DreamteamWRO/DreamteamWRO/IMG20260910141040.jpg

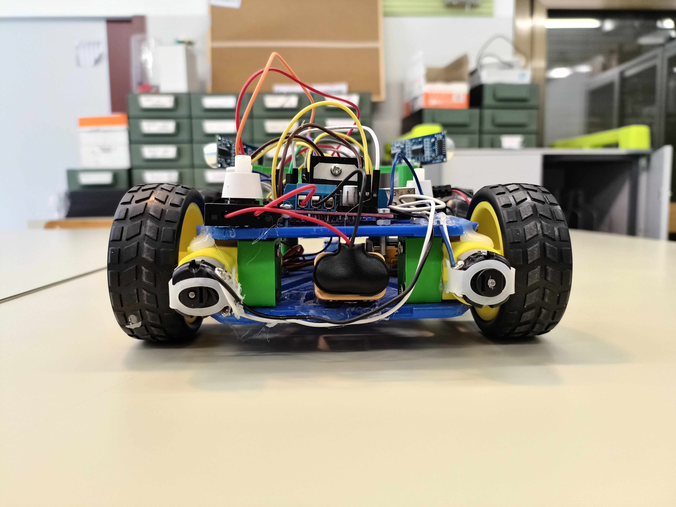
IMG20260910141040.jpg
