DreamteamWRO/DreamteamWRO/IMG20260910141033.jpg

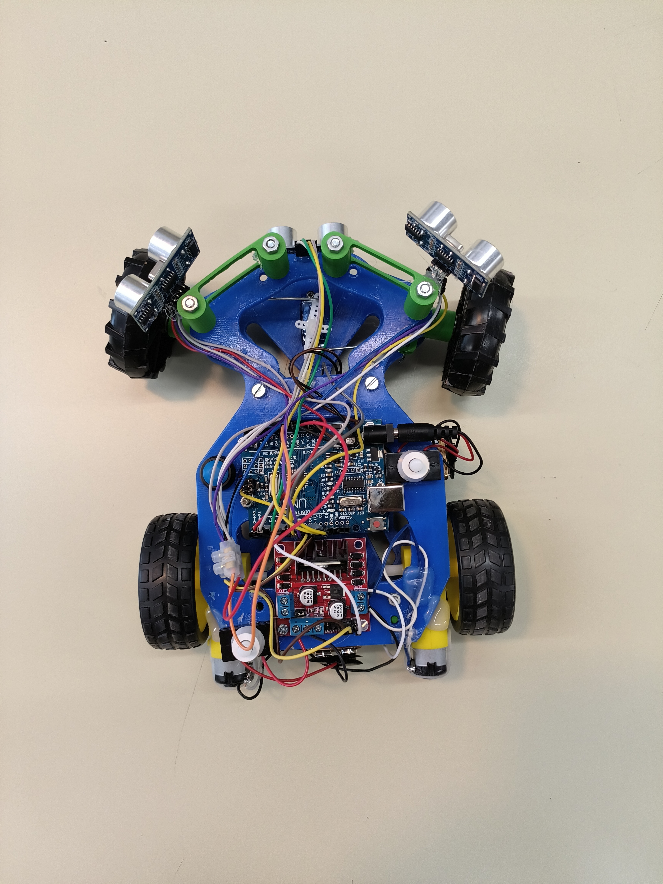
IMG20260910141033.jpg
