DreamteamWRO/DreamteamWRO/README.md

Introduction
This project consists of the construction of an Arduino Uno autonomous computer prototype, two ultrasonic sensors, a motor controller and a 3D printed chassis. The parts that must withstand the most effort have been printed in blue PETG, while the rest have been manufactured in green PLA.

Objectius
Build a functional xassis and assemble the basic electronics.
Integrate two ultrasonic sensors for frontal and lateral detection.
Assemble and test the motors and the power controller.
Document the entire process in a technical diary 
There are all things that cannot be done in the way we have planned/structured

Contextualization
Project realization to participate in the competition 
The initial design of the xassis was obtained from Thingiverse and was subsequently modified to include a second ultrasonic sensor along with a drilling process and structural reinforcement.

Relationship between the three jobs
Please consult the code designs, user guides for the ultrasound sensor and control examples (for the motors) with the Arduino Uno to avoid synchronization problems. However, we still follow the structure of the Thingiverse designer, since it has an initial process other than “thinking”, which we partly do not have to deepen so much in our time.

Motivation
Interest in basic robotics and electronic control.
Opportunity to compete in a contest/competition
Learn how to apply 3D printing on structural fish.
Work in team
