DreamteamWRO/DreamteamWRO/codig tecno.pdf

int IN1 = 2;

int IN2 = 3;

int ENA = 5;

int IN3 = 7;

int IN4 = 8;

int ENB = 9;

int VELOCIDAD;

void setup(){

pinMode(IN1, OUTPUT);

pinMode(IN2, OUTPUT);

pinMode(ENA, OUTPUT);

pinMode(IN3, OUTPUT);

pinMode(IN4, OUTPUT);

pinMode(ENB, OUTPUT);

}

void loop(){

VELOCIDAD = 100;

aAvance(VELOCIDAD);

bAvance(VELOCIDAD);

dalay(3000);

detieneAmbos();

delay(2000);

aAbance(VELOCIDAD);

dalay(1000);

detieneAmbos();

delay(2000);

}

void aAvance(int veloc){

analoglWrite(ENA, veloc);

digitalWrite(IN1, LOW);

digitalWrite(IN2, HIGH);

}

void bAvance(int veloc){

analogwrite(ENB, veloc);

digitalWrite(IN3, LOW);

digitalWrite(IN4, HIGH);

}

void detieneAmbos(){

analogWrite(ENA, 0);

analogWrite(ENB, 0);
