DreamteamWRO/DreamteamWRO/IMG20260910141046.jpg

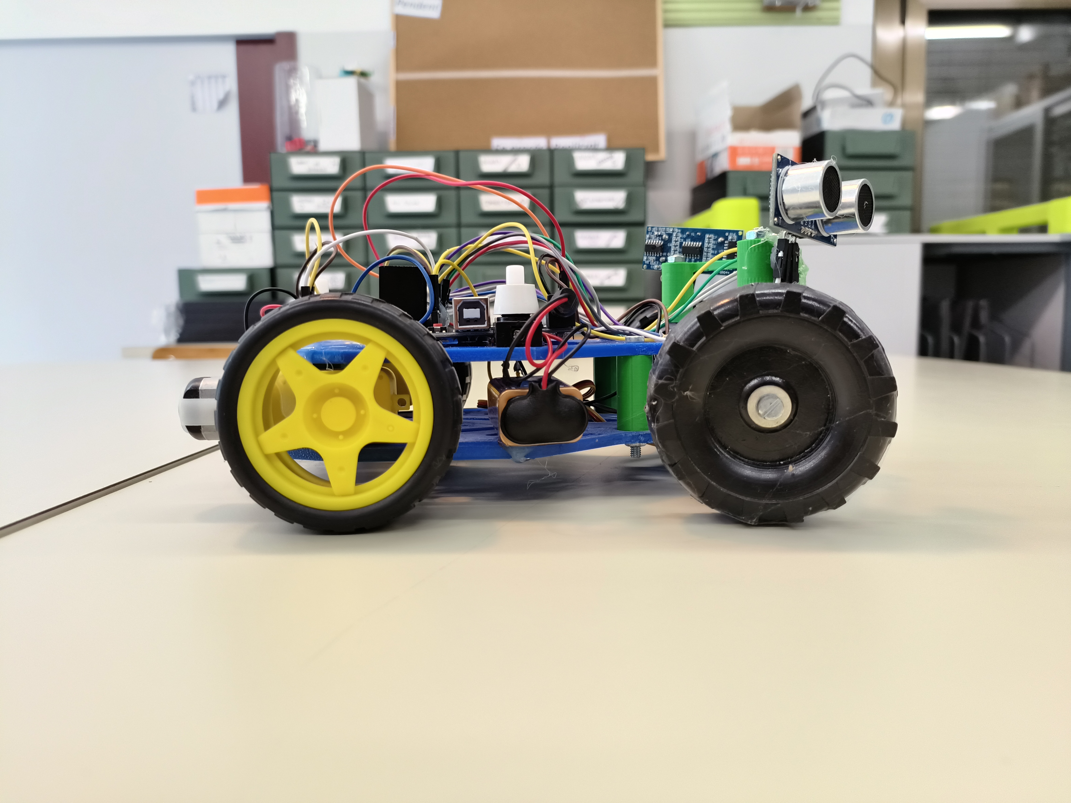
IMG20260910141046.jpg
