DreamteamWRO/DreamteamWRO/IMG20260910141053.jpg

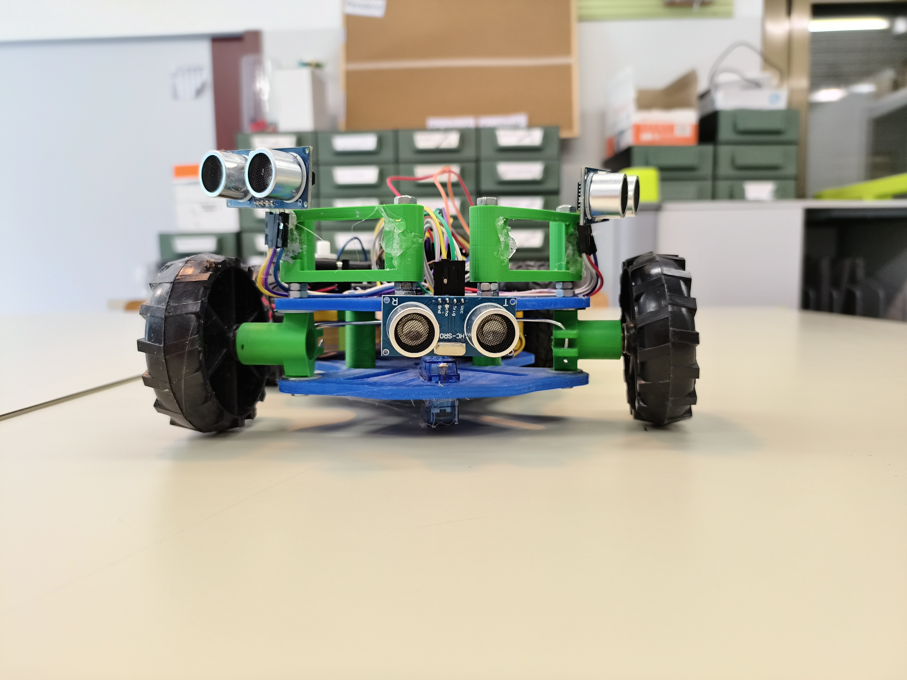
IMG20260910141053.jpg
