DreamteamWRO/DreamteamWRO/IMG20260910141100.jpg

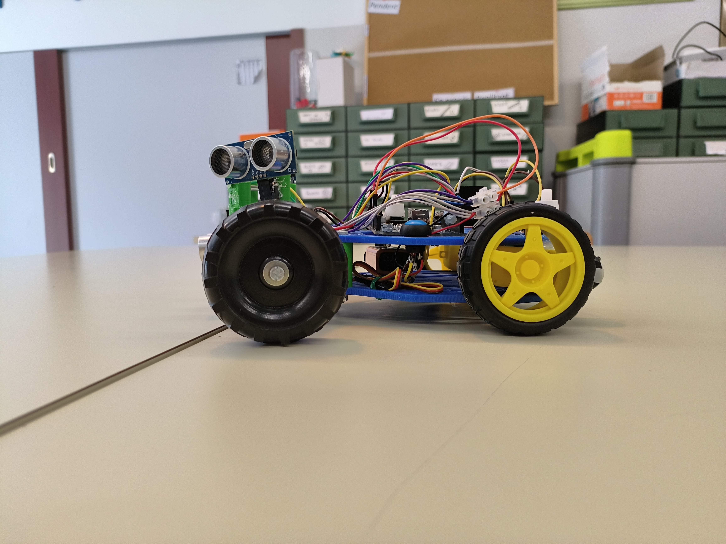
IMG20260910141100.jpg
