DreamteamWRO/DreamteamWRO/IMG20260910141115.jpg

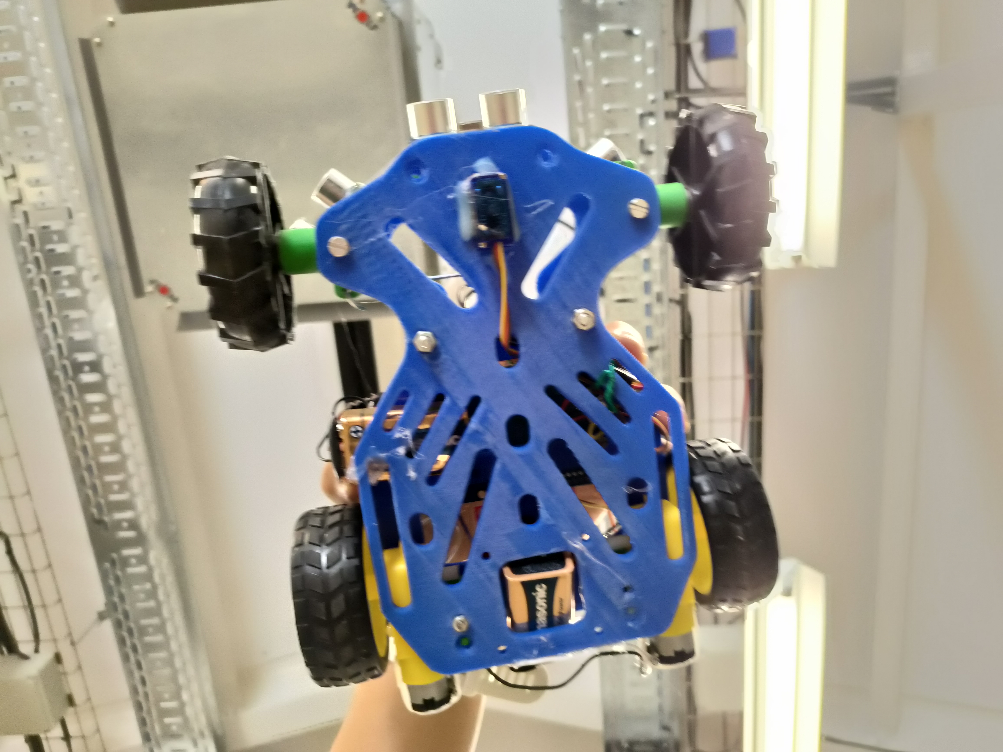
IMG20260910141115.jpg
