DreamteamWRO/DreamteamWRO/Chassis_UP.STL

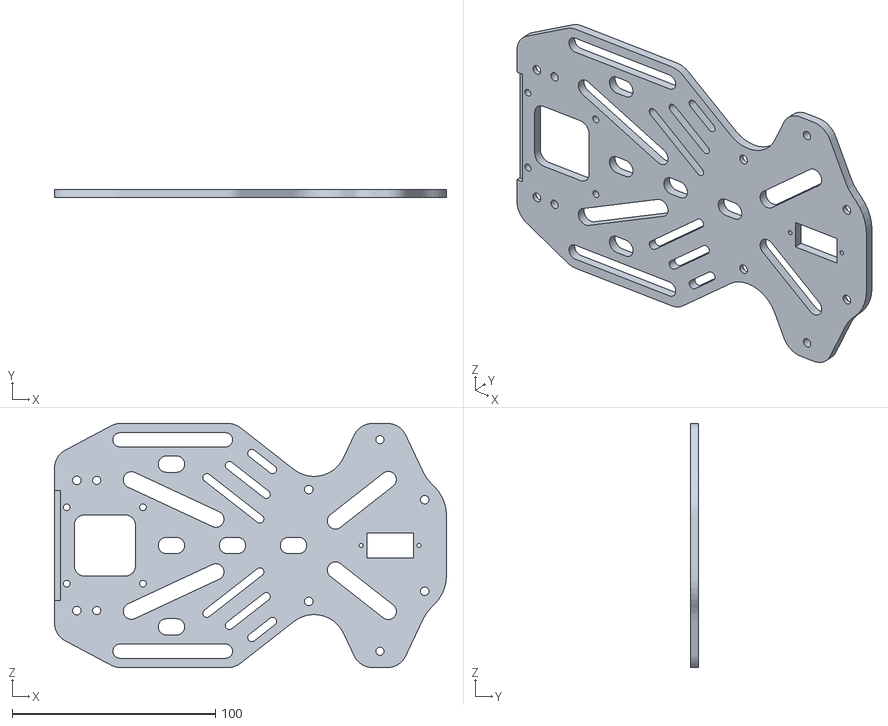
[picture p11: CAD file, 2026-09-11]
Chassis_UP.STL
192.7 x 4.00 x 120.0
