DreamteamWRO/DreamteamWRO/spacer.STL

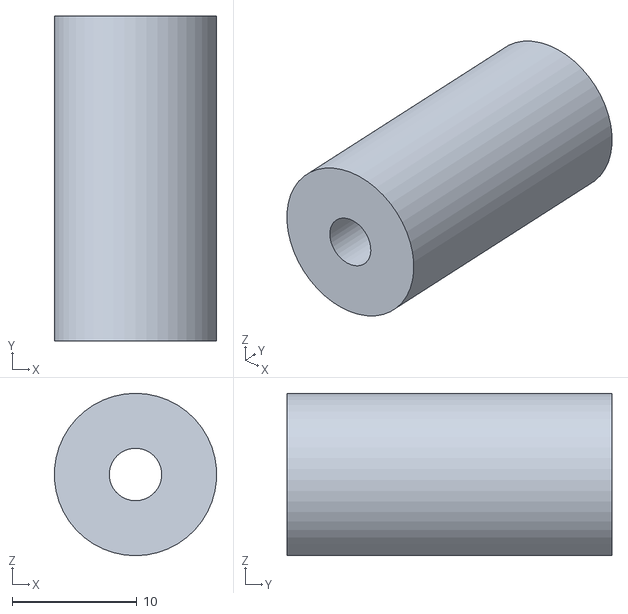
[picture p12: CAD file, 2026-09-11]
spacer.STL
13.0 x 26.0 x 13.0
