DreamteamWRO/DreamteamWRO/pivot_hub.STL

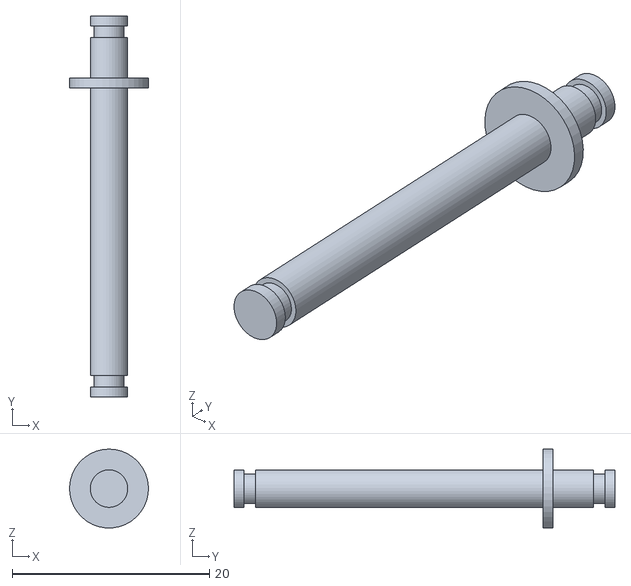
[picture p13: CAD file, 2026-09-11]
pivot_hub.STL
7.99 x 38.6 x 7.99
