DreamteamWRO/DreamteamWRO/Chassis_DOWN.STL

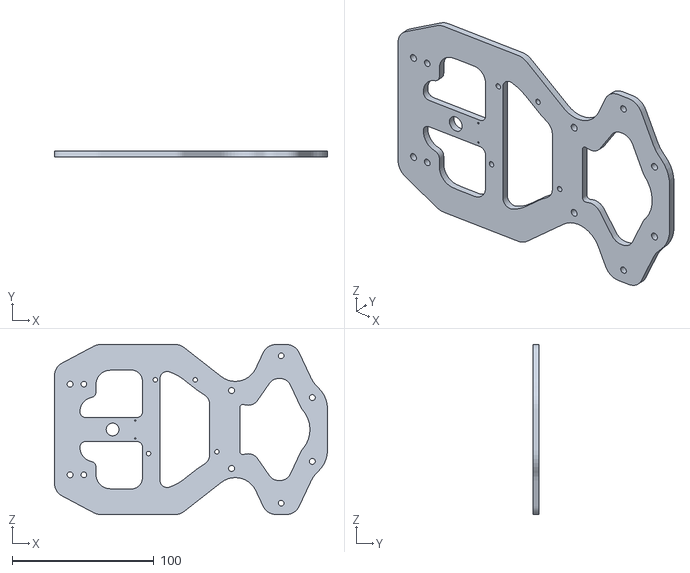
[picture p14: CAD file, 2026-09-11]
Chassis_DOWN.STL
192.7 x 4.00 x 120.0
