DreamteamWRO/DreamteamWRO/wheelmotor_support.STL

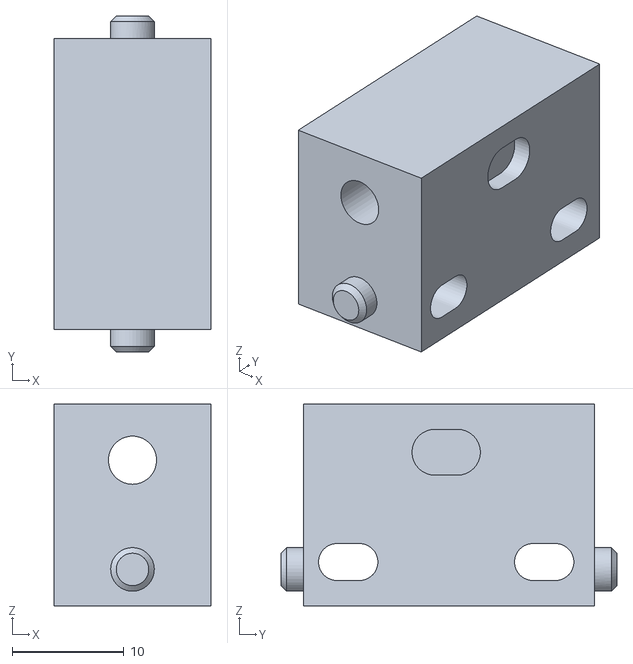
[picture p15: CAD file, 2026-09-11]
wheelmotor_support.STL
14.0 x 30.0 x 18.0
