DreamteamWRO/DreamteamWRO/seeger.STL

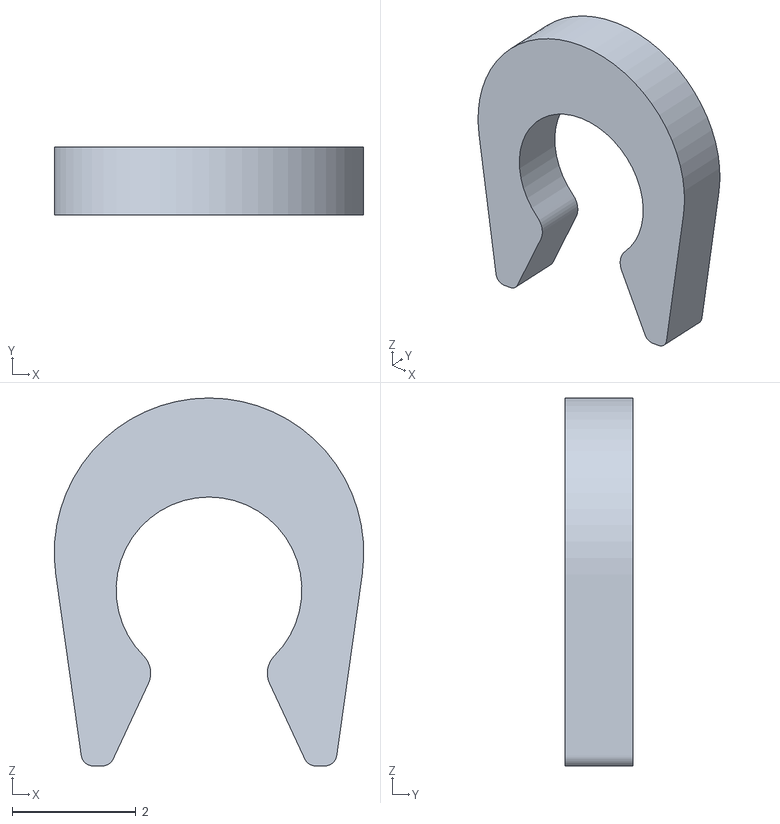
[picture p16: CAD file, 2026-09-11]
seeger.STL
5.00 x 1.10 x 5.94
