DreamteamWRO/DreamteamWRO/Hub_front.STL

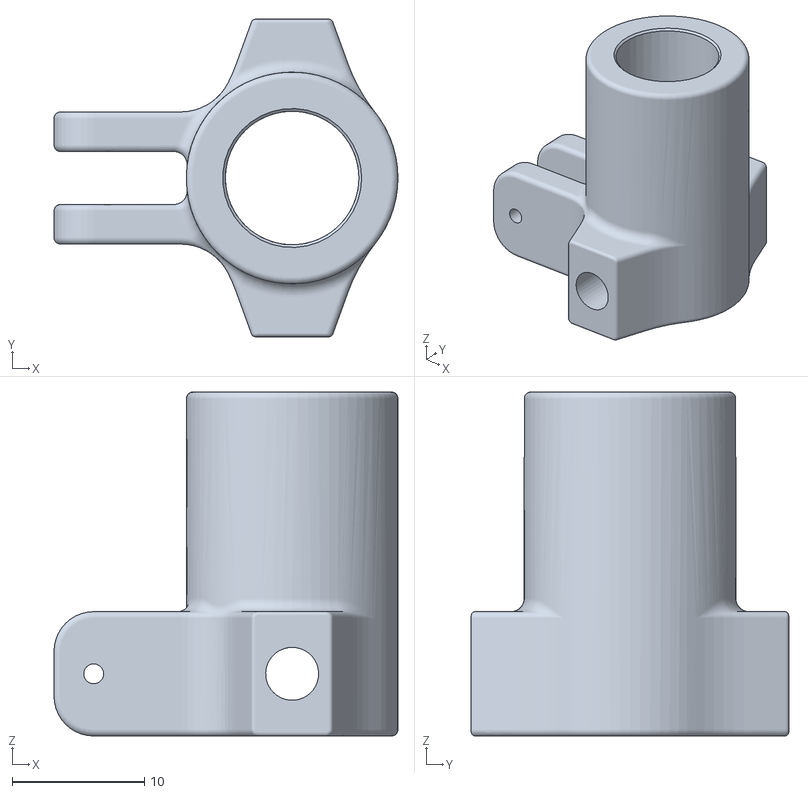
[picture p17: CAD file, 2026-09-11]
Hub_front.STL
26.0 x 24.0 x 26.0
