DreamteamWRO/DreamteamWRO/driveshaft_front.STL

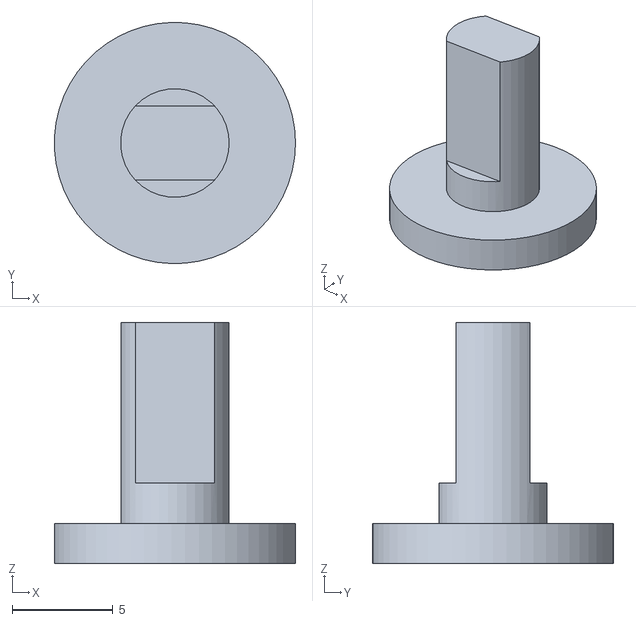
[picture p18: CAD file, 2026-09-11]
driveshaft_front.STL
12.0 x 12.0 x 12.0
