DreamteamWRO/DreamteamWRO/steering_bar.STL

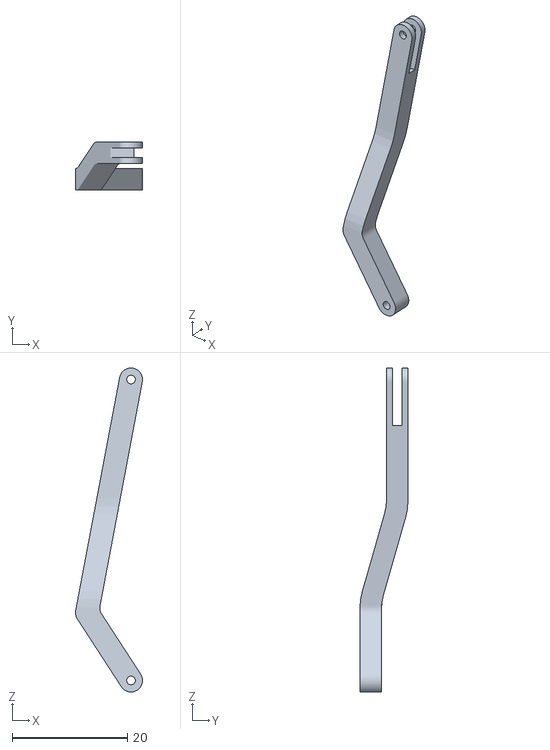
[picture p19: CAD file, 2026-09-11]
steering_bar.STL
11.6 x 8.30 x 56.1
