DreamteamWRO/DreamteamWRO/Frontal.STL

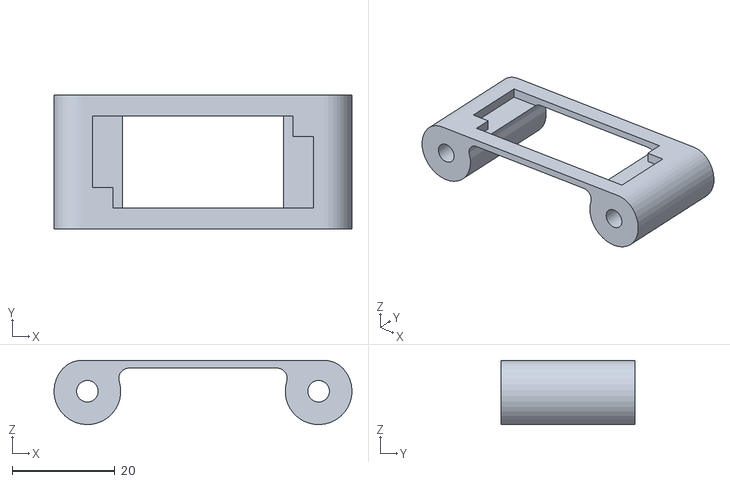
[picture p20: CAD file, 2026-09-11]
Frontal.STL
58.0 x 26.0 x 12.5
