DreamteamWRO/DreamteamWRO/washer.STL

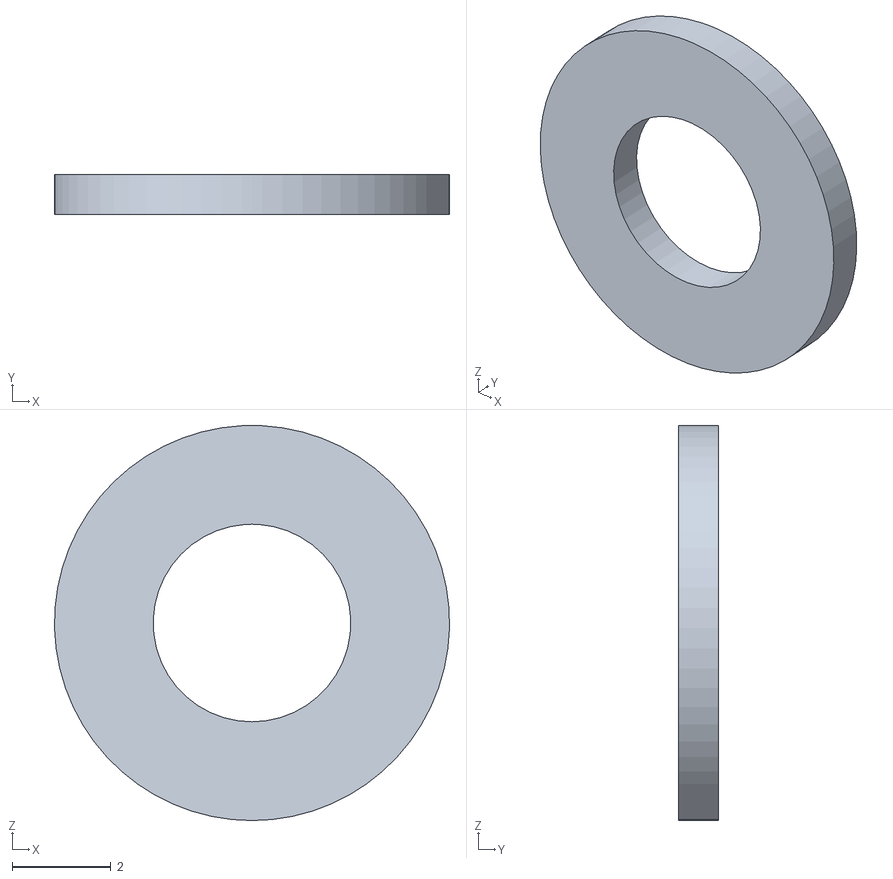
[picture p21: CAD file, 2026-09-11]
washer.STL
8.00 x 0.8 x 8.00
