DreamteamWRO/DreamteamWRO/(commit log)

2026-06-18 Programación utilizada en fase local Andorra.
    Codigo para desafio abierto. Se debe configurar cada sentido de giro.
2026-09-11 3D design of the robot
    [Chassis_DOWN.STL, Chassis_UP.STL, Frontal.STL, Hub_front.STL, driveshaft_front.STL, pivot_hub.STL, seeger.STL, spacer.STL]
